captainchapster/Eigentime32/hardware/README.md

# Hardware

KiCad project goes here (`Eigentime32.kicad_pro`). Schematic order: power → RTC → MCU → LCD → lid/buttons → NFC.

Board: ~40 mm round, 0.8 mm, 2 layers. Front side bare under the LCD; all parts on the back around the CR2032 holder.
