captainchapster/Eigentime32/docs/renders/angled.png

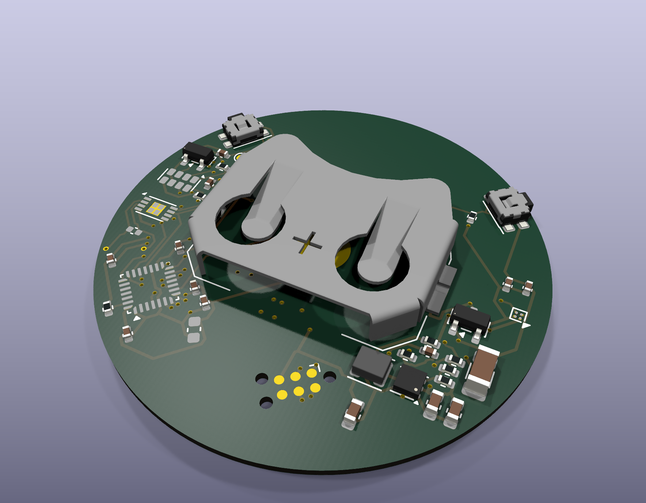
docs/renders/angled.png
