captainchapster/Eigentime32/docs/renders/bottom.png

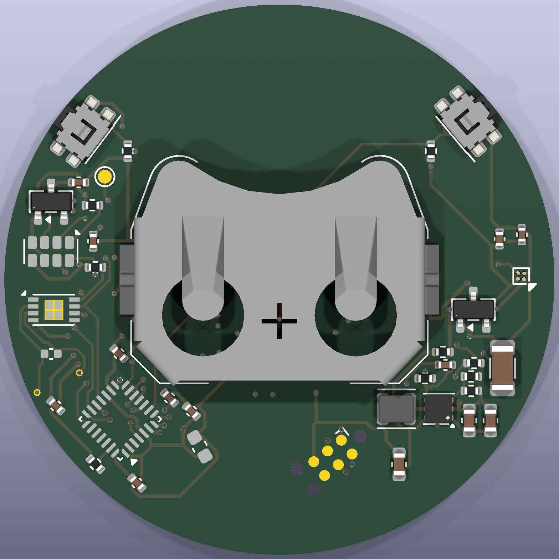
docs/renders/bottom.png
