captainchapster/Eigentime32/docs/renders/top.png

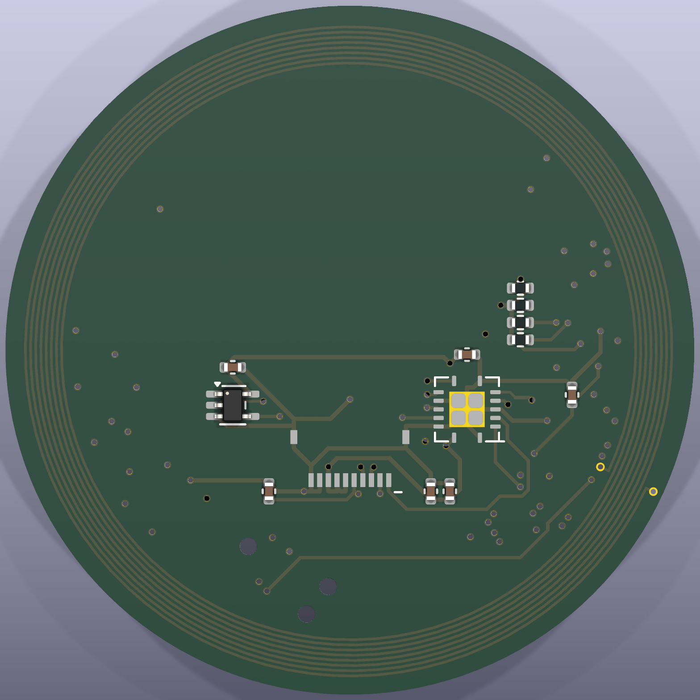
docs/renders/top.png
