captainchapster/Eigentime32/docs/renders/top_with_lcd.png

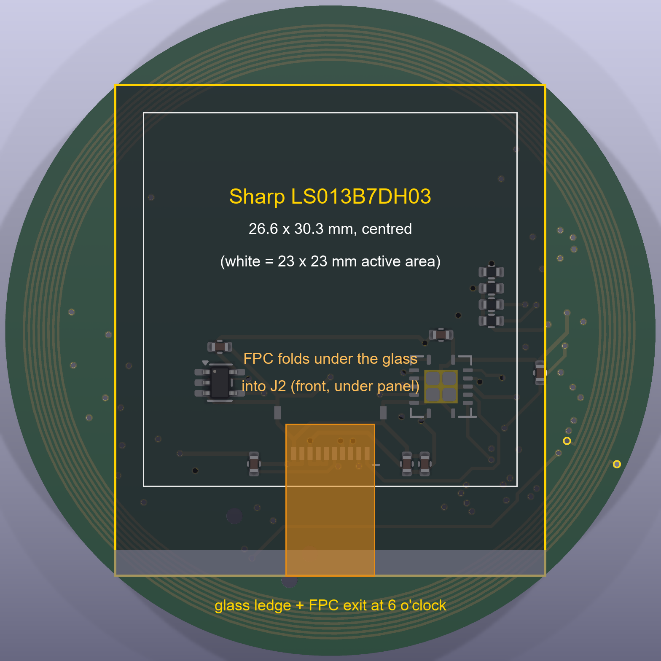
docs/renders/top_with_lcd.png
