captainchapster/Eigentime32/hardware/fab/Eigentime32_BOM_JLC.csv

Comment | Designator | Footprint | LCSC Part #
Keystone 3034 CR2032 retainer | BT1 | BatteryHolder_Keystone_3034_1x20mm_SmallNegPad | C5213768
100uF 6.3V X5R 1206 (CL31A107MQHNNNE) | C2 | C_1206_3216Metric | C15008
100nF 16V X7R 0402 (CL05B104KO5NNNC) | C3,C9,C10,C11,C12,C15,C16,C17,C20,C21 | C_0402_1005Metric | C1525
10uF 10V X5R 0603 (CL10A106KP8NNNC) | C4,C5,C6 | C_0603_1608Metric | C19702
1uF 25V X5R 0402 (CL05A105KA5NQNC) | C7,C13,C18,C19,C23 | C_0402_1005Metric | C52923
470nF 10V X5R 0402 (CL05A474KP5NNNC) | C8 | C_0402_1005Metric | C47339
1uH 2.5A WE-MAPI 2512 (Wurth 74438323010) | L1 | L_Wuerth_MAPI-2512 | C7038984
DMG2305UX-7 P-MOSFET SOT-23 | Q1 | SOT-23 | C150470
402k 1% 0402 (0402WGF4023TCE) | R1 | R_0402_1005Metric | C25785
200k 1% 0402 (0402WGF2003TCE) | R2 | R_0402_1005Metric | C25764
1M 1% 0402 (0402WGF1004TCE) | R3,R5,R12,R13,R14 | R_0402_1005Metric | C26083
470R 1% 0402 (0402WGF4700TCE) | R4 | R_0402_1005Metric | C25117
10k 1% 0402 (0402WGF1002TCE) | R6,R7,R9,R10 | R_0402_1005Metric | C25744
100k 1% 0402 (0402WGF1003TCE) | R15 | R_0402_1005Metric | C25741
Panasonic EVQ-P7A01P | SW2,SW3 | SW_SPST_EVQP7A | C79167
RV-3032-C7 32.768kHz 2.5ppm TA-QC | U1 | MicroCrystal_C7_SON-8_1.5x3.2mm_P0.9mm | C5127802
STM32L031G6U6TR | U2 | QFN-28_4x4mm_P0.5mm | C883300
TPS61099DRVR | U3 | WSON-6-1EP_2x2mm_P0.65mm_EP1x1.6mm | C2842395
TPS22916CYFPR | U5 | Texas_PicoStar_BGA-4_0.758x0.758mm_Layout2x2_P0.4mm | C2680319
ST25DV04KC-IE8C3 (UFDFPN8) | U8 | DFN-8-1EP_3x2mm_P0.5mm_EP1.36x1.46mm | C5221756
CT8132SK-IS3 | U9 | SOT-23 | C22423395
Panasonic AYF531035 FPC 10P 0.5mm | J2 | Panasonic_AYF531035_1x10-1MP_P0.5mm_Horizontal | C425133
470k 1% 0402 (0402WGF4703TCE) | R8 | R_0402_1005Metric | C25790
SN74LV4T125RGYR | U6 | Texas_RGY0014A_VQFN-14-1EP_3.5x3.5mm_P0.5mm_EP2.05x2.05mm | C411879
SN74LV1T34DCKR | U7 | SOT-353_SC-70-5 | C78541
