captainchapster/Eigentime32/case/stl/eigentime32_case.step

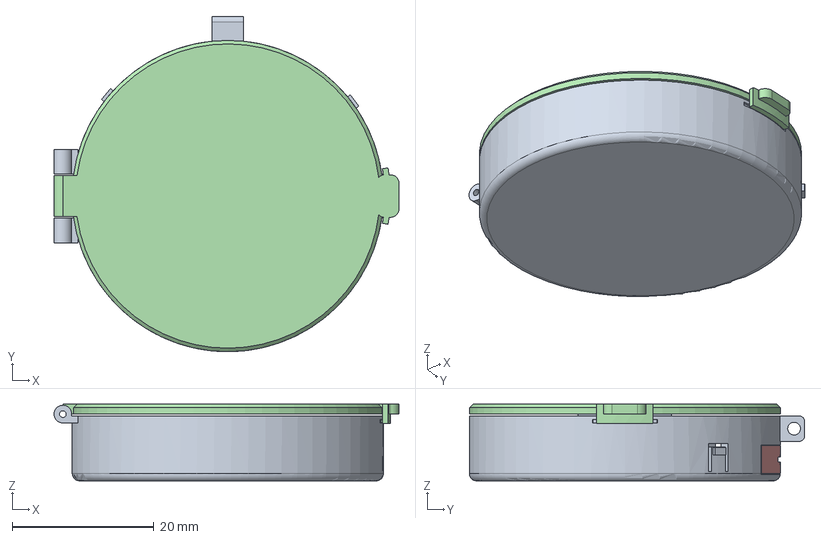
[picture p12: CAD file, 2026-10-10]
case/stl/eigentime32_case.step
48.6 x 47.3 x 10.8 mm
bezel
frame
lid
cell_door
