captainchapster/Eigentime32/case/stl/shell.step

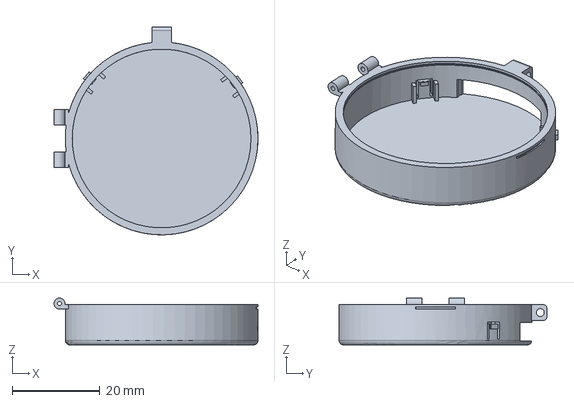
[picture p13: CAD file, 2026-10-10]
case/stl/shell.step
46.4 x 47.3 x 10.7 mm
