captainchapster/Eigentime32/case/stl/lid.step

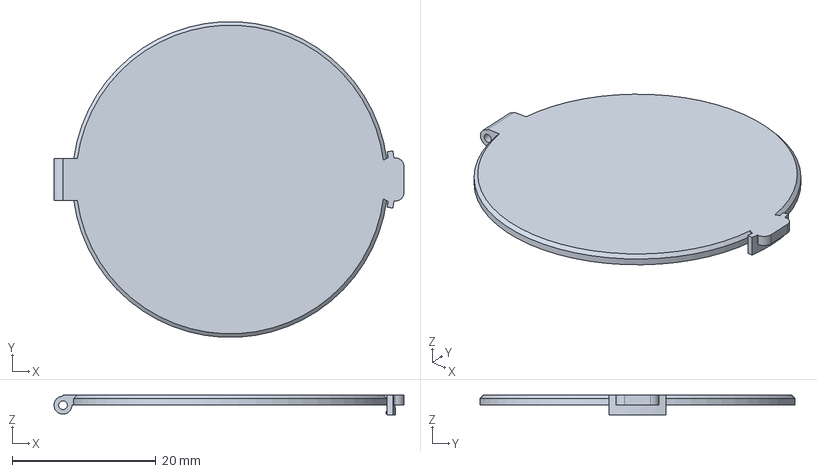
[picture p14: CAD file, 2026-10-10]
case/stl/lid.step
48.6 x 43.8 x 2.75 mm
