captainchapster/Eigentime32/case/stl/bezel.step

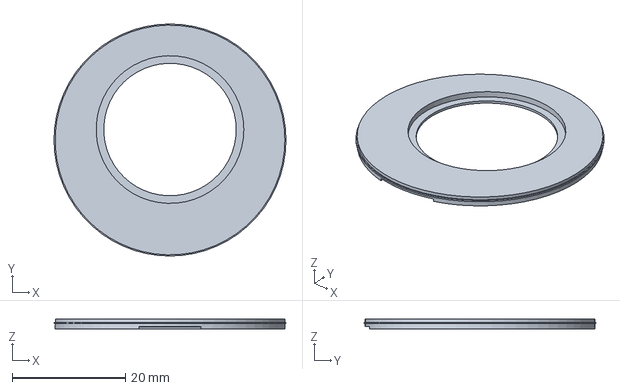
[picture p15: CAD file, 2026-10-10]
case/stl/bezel.step
41.0 x 41.0 x 1.70 mm
