captainchapster/Eigentime32/case/stl/frame.step

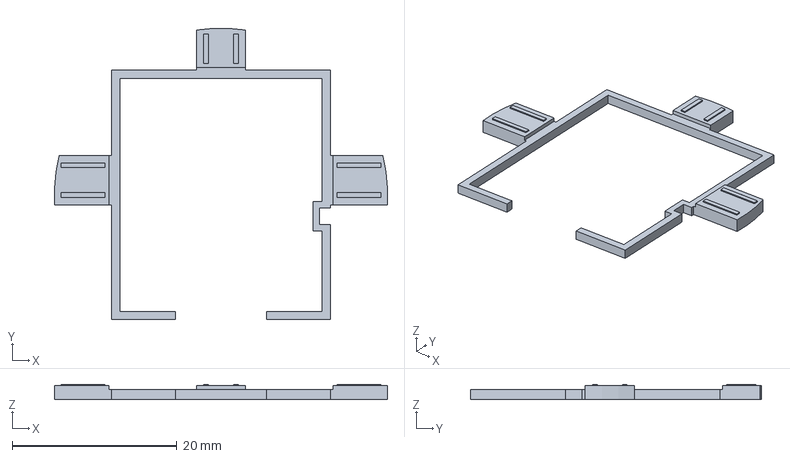
[picture p16: CAD file, 2026-10-10]
case/stl/frame.step
40.5 x 35.4 x 1.85 mm
