captainchapster/Eigentime32/case/stl/cell_door.step

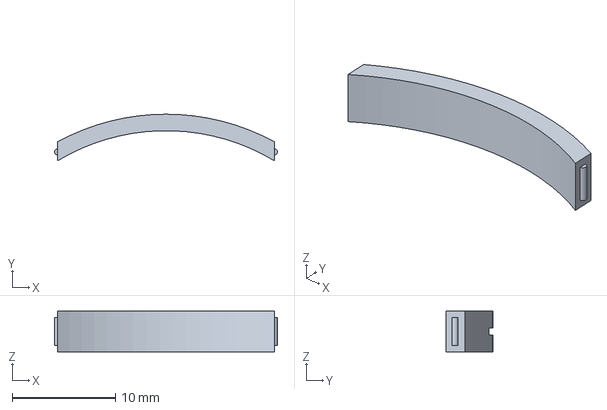
[picture p17: CAD file, 2026-10-10]
case/stl/cell_door.step
21.6 x 4.52 x 3.96 mm
