captainchapster/Eigentime32/(list of files, cad)

Other CAD files:
case/stl/bezel.stl
case/stl/cell_door.stl
case/stl/frame.stl
case/stl/lid.stl
case/stl/shell.stl
