captainchapster/Eigentime32/hardware/Eigentime32.kicad_pcb

## KiCad design hardware/Eigentime32.kicad_pcb (2026-10-10)

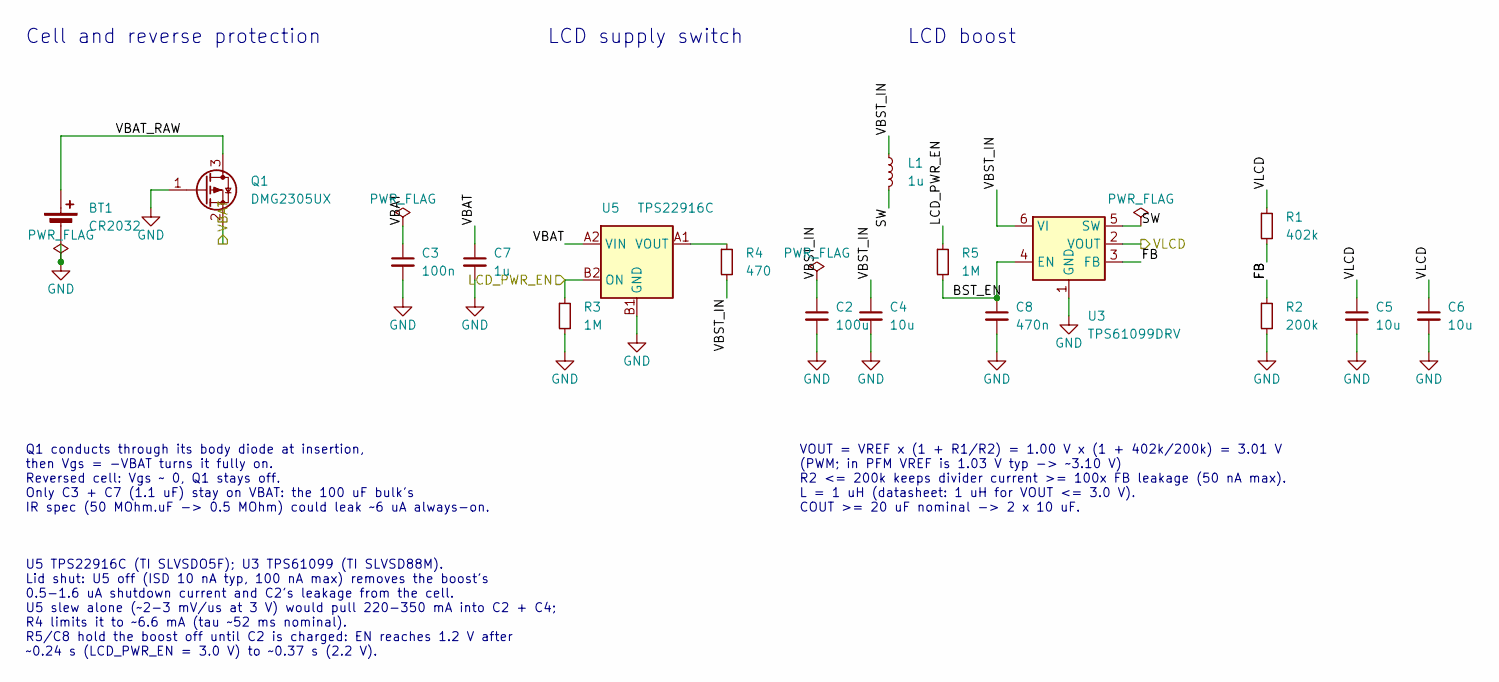
[picture p18: schematic power.kicad_sch, Eigentime32 - Power]

Parts:
BT1: CR2032; BatteryHolder_Keystone_3034_1x20mm_SmallNegPad; MPN 3034
C2: 100u; C_1206_3216Metric; MPN CL31A107MQHNNNE
C3: 100n; C_0402_1005Metric; MPN GRM155R71C104KA88D
C4, C5, C6: 10u; C_0603_1608Metric; MPN GRM188R60J106ME84D
C7: 1u; C_0402_1005Metric; MPN GRM155R61A105KE15D
C8: 470n; C_0402_1005Metric; MPN GRM155R61A474KE15D
L1: 1u; L_Wuerth_MAPI-2512; MPN 74404024010
Q1: DMG2305UX; SOT-23; MPN DMG2305UX-7
R1: 402k; R_0402_1005Metric; MPN RC0402FR-07402KL
R2: 200k; R_0402_1005Metric; MPN RC0402FR-07200KL
R3, R5: 1M; R_0402_1005Metric; MPN RC0402FR-071ML
R4: 470; R_0402_1005Metric; MPN RC0402FR-07470RL
U3: TPS61099DRV; WSON-6-1EP_2x2mm_P0.65mm_EP1x1.6mm; MPN TPS61099DRVR
U5: TPS22916C; Texas_PicoStar_BGA-4_0.758x0.758mm_Layout2x2_P0.4mm; MPN TPS22916CYFPR

Connections:
/LCD_PWR_EN: R3.1, R5.1, U5.B2 (ON); also elsewhere on the board
/Power/BST_EN: C8.1, R5.2, U3.4 (EN)
/Power/FB: R1.2, R2.1, U3.3 (FB)
/Power/SW: L1.2, U3.5 (SW)
/Power/VBAT_RAW: BT1.1 (+), Q1.3 (D)
/Power/VBST_IN: C2.1, C4.1, L1.1, R4.2, U3.6 (VI)
/VBAT: C3.1, C7.1, Q1.2 (S), U5.A2 (VIN); also elsewhere on the board
/VLCD: C5.1, C6.1, R1.1, U3.2 (VOUT); also elsewhere on the board
GND: BT1.2 (-), C2.2, C3.2, C4.2, C5.2, C6.2, C7.2, C8.2, Q1.1 (G), R2.2, R3.2, U3.1 (GND), U3.7 (GND), U5.B1 (GND); also elsewhere on the board
unnamed: R4.1, U5.A1 (VOUT)

Notes on the sheet:
Cell and reverse protection
Q1 conducts through its body diode at insertion, then Vgs = -VBAT turns it fully on. Reversed cell: Vgs ~ 0, Q1 stays off. Only C3 + C7 (1.1 uF) stay on VBAT: the 100 uF bulk's IR spec (50 MOhm.uF -> 0.5 MOhm) could leak ~6 uA always-on.
LCD supply switch
LCD boost
U5 TPS22916C (TI SLVSDO5F); U3 TPS61099 (TI SLVSD88M). Lid shut: U5 off (ISD 10 nA typ, 100 nA max) removes the boost's 0.5-1.6 uA shutdown current and C2's leakage from the cell. U5 slew alone (~2-3 mV/us at 3 V) would pull 220-350 mA into C2 + C4; R4 limits it to ~6.6 mA (tau ~52 ms nominal). R5/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
VOUT = VREF x (1 + R1/R2) = 1.00 V x (1 + 402k/200k) = 3.01 V (PWM; in PFM VREF is 1.03 V typ -> ~3.10 V) R2 <= 200k keeps divider current >= 100x FB leakage (50 nA max). L = 1 uH (datasheet: 1 uH for VOUT <= 3.0 V). COUT >= 20 uF nominal -> 2 x 10 uF.

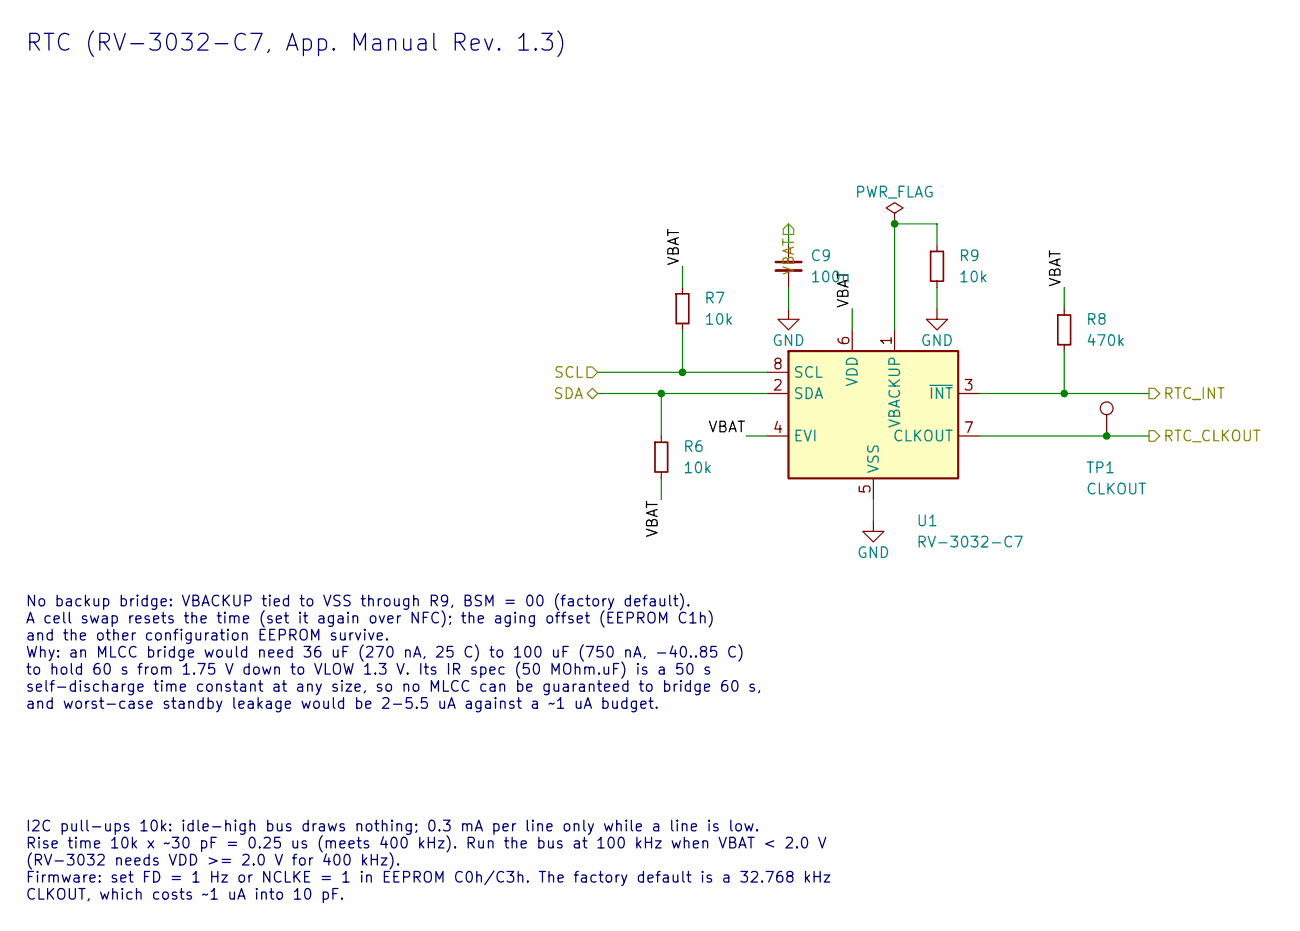
[picture p19: schematic rtc.kicad_sch, Eigentime32 - RTC]

Parts:
C9: 100n; C_0402_1005Metric; MPN GRM155R71C104KA88D
R6, R7, R9: 10k; R_0402_1005Metric; MPN RC0402FR-0710KL
R8: 470k; R_0402_1005Metric; MPN RC0402FR-07470KL
TP1: CLKOUT; TestPoint_Pad_D1.0mm
U1: RV-3032-C7; MicroCrystal_C7_SON-8_1.5x3.2mm_P0.9mm; MPN RV-3032-C7 32.768kHz 2.5ppm-TA-QC

Connections:
/RTC_CLKOUT: TP1.1, U1.7 (CLKOUT); also elsewhere on the board
/RTC_INT: R8.2, U1.3 (~INT); also elsewhere on the board
/SCL: R7.2, U1.8 (SCL); also elsewhere on the board
/SDA: R6.1, U1.2 (SDA); also elsewhere on the board
/VBAT: C9.1, R6.2, R7.1, R8.1, U1.4 (EVI), U1.6 (VDD); also elsewhere on the board
GND: C9.2, R9.2, U1.5 (VSS); also elsewhere on the board
unnamed: R9.1, U1.1 (VBACKUP)

Notes on the sheet:
RTC (RV-3032-C7, App. Manual Rev. 1.3)
No backup bridge: VBACKUP tied to VSS through R9, BSM = 00 (factory default). A cell swap resets the time (set it again over NFC); the aging offset (EEPROM C1h) and the other configuration EEPROM survive. Why: an MLCC bridge would need 36 uF (270 nA, 25 C) to 100 uF (750 nA, -40..85 C) to hold 60 s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
I2C pull-ups 10k: idle-high bus draws nothing; 0.3 mA per line only while a line is low. Rise time 10k x ~30 pF = 0.25 us (meets 400 kHz). Run the bus at 100 kHz when VBAT < 2.0 V (RV-3032 needs VDD >= 2.0 V for 400 kHz). Firmware: set FD = 1 Hz or NCLKE = 1 in EEPROM C0h/C3h. The factory default i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

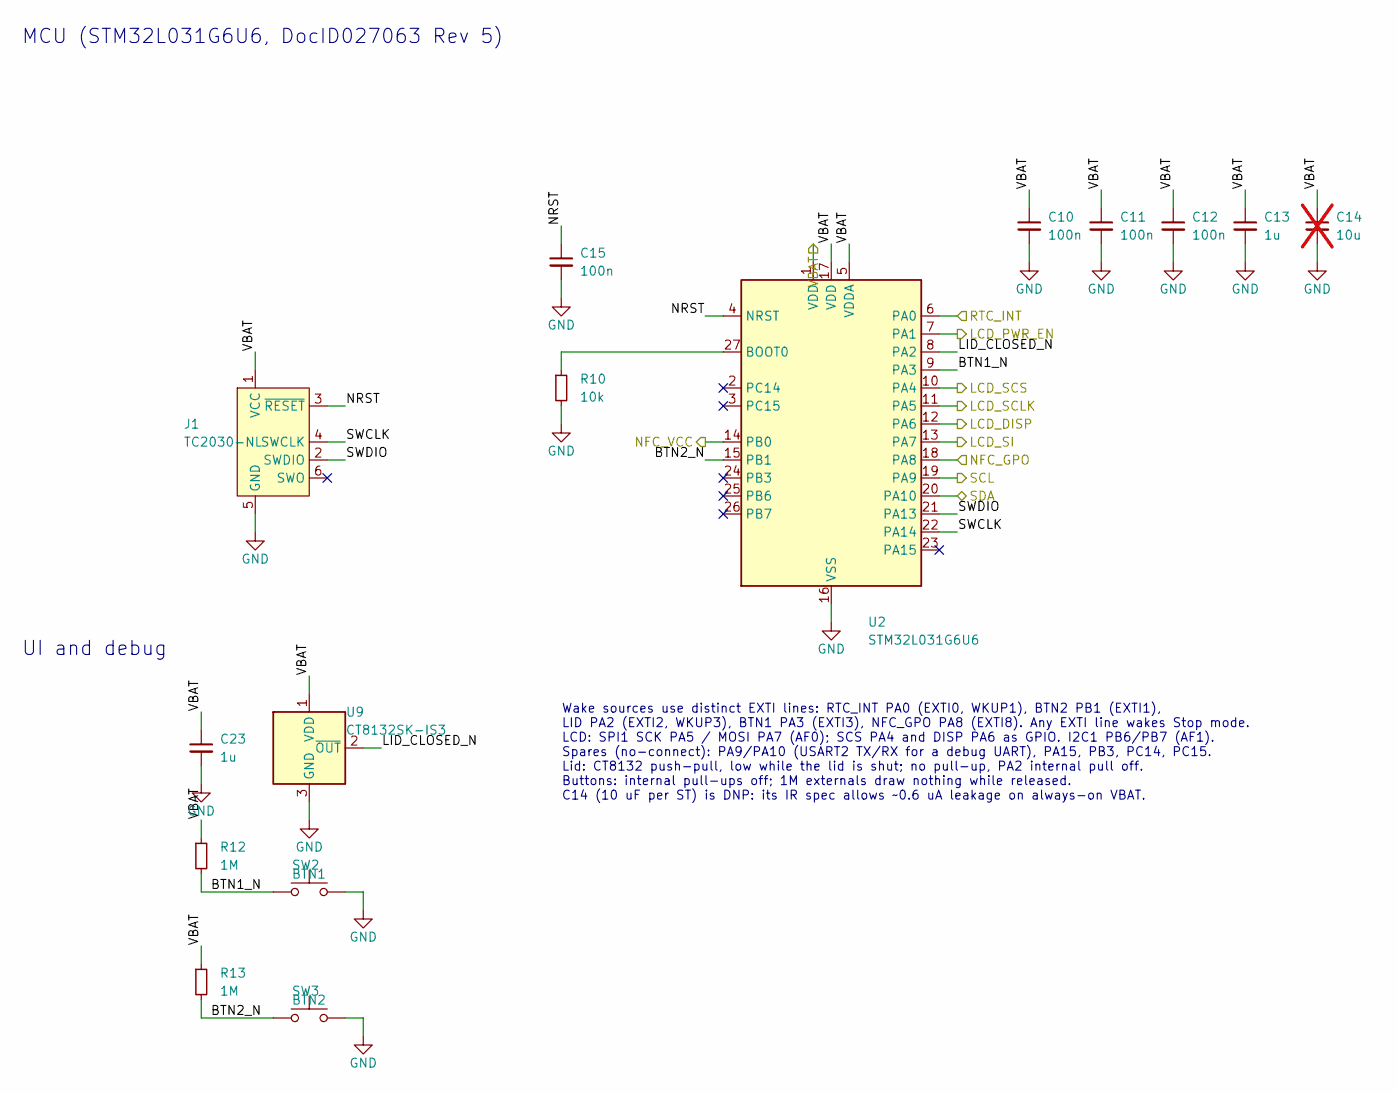
[picture p20: schematic mcu.kicad_sch, Eigentime32 - MCU]

Parts:
C10, C11, C12, C15: 100n; C_0402_1005Metric; MPN GRM155R71C104KA88D
C13, C23: 1u; C_0402_1005Metric; MPN GRM155R61A105KE15D
C14: 10u; C_0603_1608Metric; MPN GRM188R60J106ME84D; not fitted
J1: TC2030-NL; Tag-Connect_TC2030-IDC-NL_2x03_P1.27mm_Vertical_FootprintsA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; MPN TC2030-IDC-NL (cable)
R10: 10k; R_0402_1005Metric; MPN RC0402FR-0710KL
R12, R13: 1M; R_0402_1005Metric; MPN RC0402FR-071ML
SW2: BTN1; SW_SPST_EVQP7A; MPN EVQ-P7A01P
SW3: BTN2; SW_SPST_EVQP7A; MPN EVQ-P7A01P
U2: STM32L031G6U6; QFN-28_4x4mm_P0.5mm; MPN STM32L031G6U6
U9: CT8132SK-IS3; SOT-23; MPN CT8132SK-IS3

Connections:
/LCD_DISP: U2.12 (PA6); also elsewhere on the board
/LCD_PWR_EN: U2.7 (PA1); also elsewhere on the board
/LCD_SCLK: U2.11 (PA5); also elsewhere on the board
/LCD_SCS: U2.10 (PA4); also elsewhere on the board
/LCD_SI: U2.13 (PA7); also elsewhere on the board
/MCU/BTN1_N: R12.2, SW2.1, U2.9 (PA3)
/MCU/BTN2_N: R13.2, SW3.1, U2.15 (PB1)
/MCU/LID_CLOSED_N: U2.8 (PA2), U9.2 (~OUT)
/MCU/NRST: C15.1, J1.3 (~RESET), U2.4 (NRST)
/MCU/SWCLK: J1.4 (SWCLK), U2.22 (PA14)
/MCU/SWDIO: J1.2 (SWDIO), U2.21 (PA13)
/NFC_GPO: U2.18 (PA8); also elsewhere on the board
/NFC_VCC: U2.14 (PB0); also elsewhere on the board
/RTC_INT: U2.6 (PA0); also elsewhere on the board
/SCL: U2.19 (PA9); also elsewhere on the board
/SDA: U2.20 (PA10); also elsewhere on the board
/VBAT: C10.1, C11.1, C12.1, C13.1, C14.1, C23.1, J1.1 (VCC), R12.1, R13.1, U2.1 (VDD), U2.5 (VDDA), U2.17 (VDD), U9.1 (VDD); also elsewhere on the board
GND: C10.2, C11.2, C12.2, C13.2, C14.2, C15.2, C23.2, J1.5 (GND), R10.2, SW2.2, SW3.2, U2.16 (VSS), U2.28 (VSS), U9.3 (GND); also elsewhere on the board
unnamed: R10.1, U2.27 (BOOT0)

Notes on the sheet:
MCU (STM32L031G6U6, DocID027063 Rev 5)
UI and debug
Wake sources use distinct EXTI lines: RTC_INT PA0 (EXTI0, WKUP1), BTN2 PB1 (EXTI1), LID PA2 (EXTI2, WKUP3), BTN1 PA3 (EXTI3), NFC_GPO PA8 (EXTI8). Any EXTI line wakes Stop mode. LCD: SPI1 SCK PA5 / MOSI PA7 (AF0); SCS PA4 and DISP PA6 as GPIO. I2C1 PB6/PB7 (AF1). Spares (no-connect): PA9/PA10 (USAR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

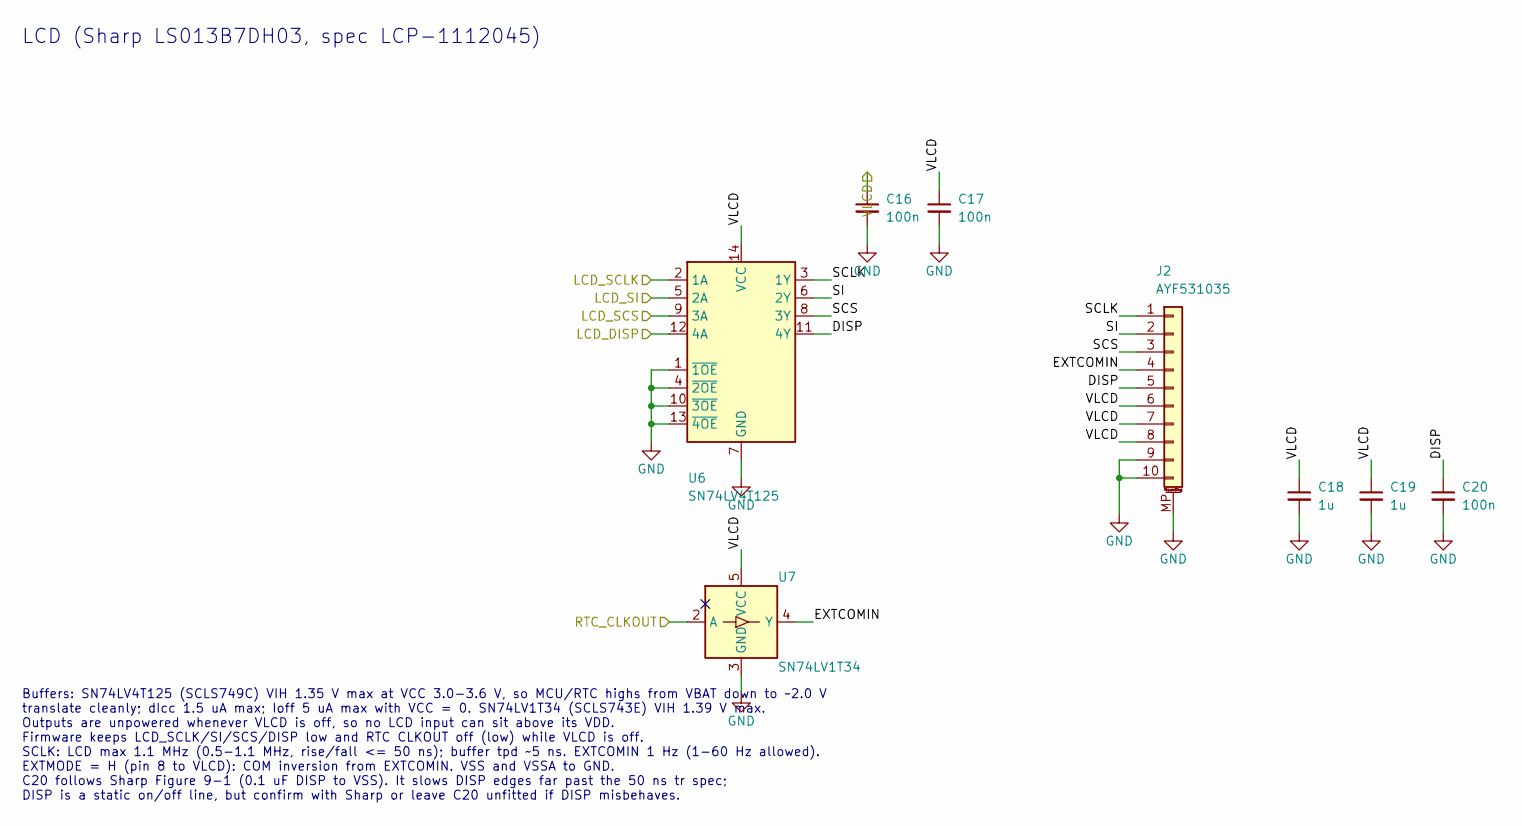
[picture p21: schematic lcd.kicad_sch, Eigentime32 - LCD]

Parts:
C16, C17, C20: 100n; C_0402_1005Metric; MPN GRM155R71C104KA88D
C18, C19: 1u; C_0402_1005Metric; MPN GRM155R61A105KE15D
J2: AYF531035; Panasonic_AYF531035_1x10-1MP_P0.5mm_Horizontal; MPN AYF531035
U6: SN74LV4T125; Texas_RGY0014A_VQFN-14-1EP_3.5x3.5mm_P0.5mm_EP2.05x2.05mm; MPN SN74LV4T125RGYR
U7: SN74LV1T34; SOT-353_SC-70-5; MPN SN74LV1T34DCKR

Connections:
/LCD/DISP: C20.1, J2.5, U6.11 (4Y)
/LCD/EXTCOMIN: J2.4, U7.4 (Y)
/LCD/SCLK: J2.1, U6.3 (1Y)
/LCD/SCS: J2.3, U6.8 (3Y)
/LCD/SI: J2.2, U6.6 (2Y)
/LCD_DISP: U6.12 (4A); also elsewhere on the board
/LCD_SCLK: U6.2 (1A); also elsewhere on the board
/LCD_SCS: U6.9 (3A); also elsewhere on the board
/LCD_SI: U6.5 (2A); also elsewhere on the board
/RTC_CLKOUT: U7.2 (A); also elsewhere on the board
/VLCD: C16.1, C17.1, C18.1, C19.1, J2.6, J2.7, J2.8, U6.14 (VCC), U7.5 (VCC); also elsewhere on the board
GND: C16.2, C17.2, C18.2, C19.2, C20.2, J2.9, J2.10, J2.MP (MountPin), U6.1 (~1OE), U6.4 (~2OE), U6.7 (GND), U6.10 (~3OE), U6.13 (~4OE), U6.15 (GND), U7.3 (GND); also elsewhere on the board

Notes on the sheet:
LCD (Sharp LS013B7DH03, spec LCP-1112045)
Buffers: SN74LV4T125 (SCLS749C) VIH 1.35 V max at VCC 3.0-3.6 V, so MCU/RTC highs from VBAT down to ~2.0 V translate cleanly; dIcc 1.5 uA max; Ioff 5 uA max with VCC = 0. SN74LV1T34 (SCLS743E) VIH 1.39 V max. Outputs are unpowered whenever VLCD is off, so no LCD input can sit above its VDD. Firmwar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

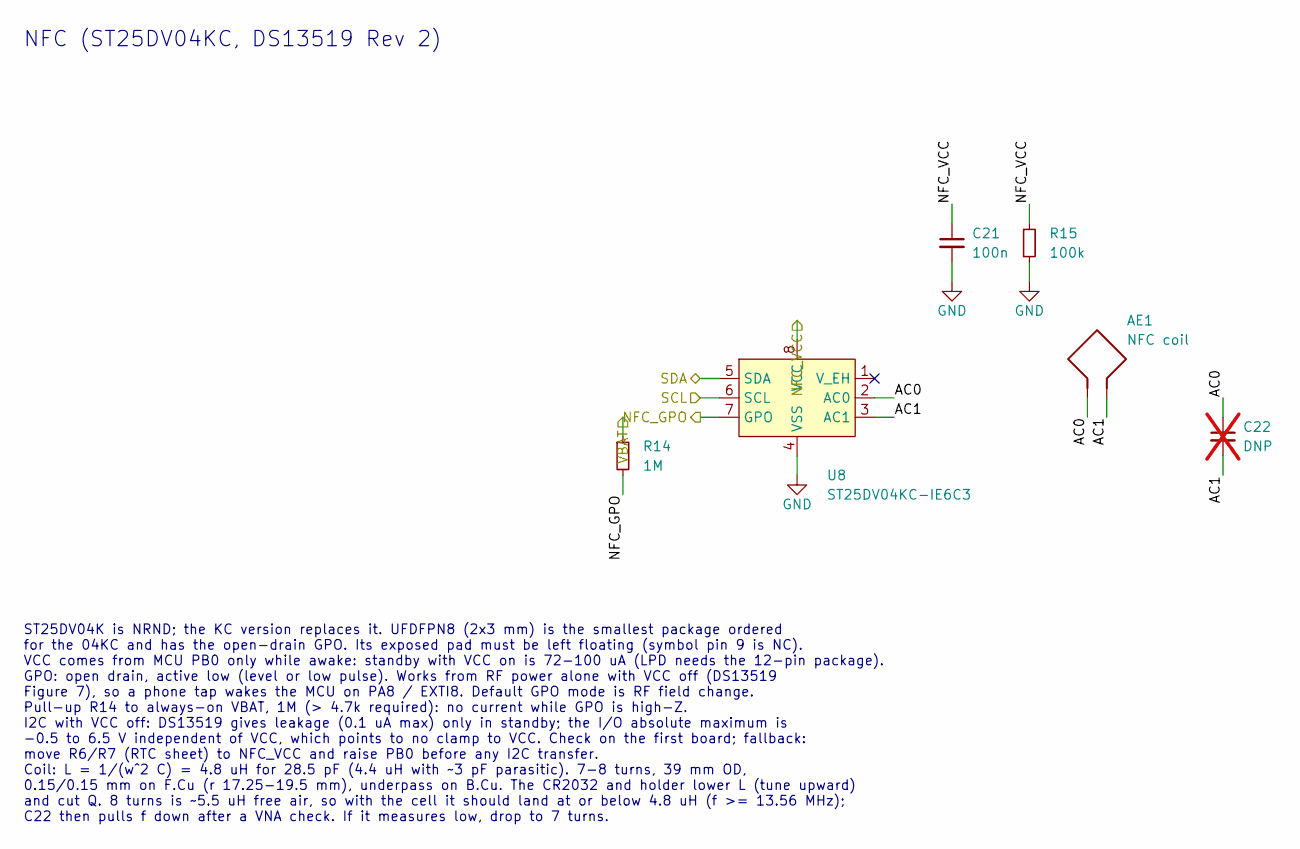
[picture p22: schematic nfc.kicad_sch, Eigentime32 - NFC]

Parts:
AE1: NFC coil; NFC_PCB_Coil_D38.1mm_8T
C21: 100n; C_0402_1005Metric; MPN GRM155R71C104KA88D
C22: DNP; C_0402_1005Metric; MPN C0G 0402, value set at tuning; not fitted
R14: 1M; R_0402_1005Metric; MPN RC0402FR-071ML
R15: 100k; R_0402_1005Metric; MPN RC0402FR-07100KL
U8: ST25DV04KC-IE6C3; DFN-8-1EP_3x2mm_P0.5mm_EP1.36x1.46mm; MPN ST25DV04KC-IE6C3

Connections:
/NFC/AC0: AE1.1, C22.1, U8.2 (AC0)
/NFC/AC1: AE1.2, C22.2, U8.3 (AC1)
/NFC_GPO: R14.2, U8.7 (GPO); also elsewhere on the board
/NFC_VCC: C21.1, R15.1, U8.8 (VCC); also elsewhere on the board
/SCL: U8.6 (SCL); also elsewhere on the board
/SDA: U8.5 (SDA); also elsewhere on the board
/VBAT: R14.1; also elsewhere on the board
GND: C21.2, R15.2, U8.4 (VSS); also elsewhere on the board

Notes on the sheet:
NFC (ST25DV04KC, DS13519 Rev 2)
ST25DV04K is NRND; the KC version replaces it. UFDFPN8 (2x3 mm) is the smallest package ordered for the 04KC and has the open-drain GPO. Its exposed pad must be left floating (symbol pin 9 is NC). VCC comes from MCU PB0 only while awake: standby with VCC on is 72-100 uA (LPD needs the 12-pin packag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

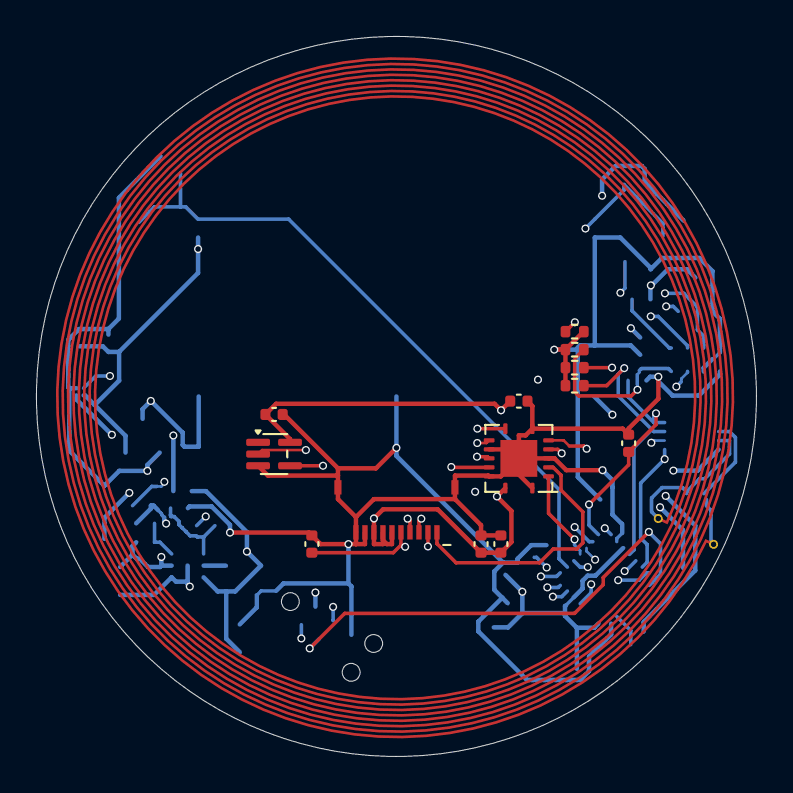
[picture p23: board Eigentime32.kicad_pcb from above]

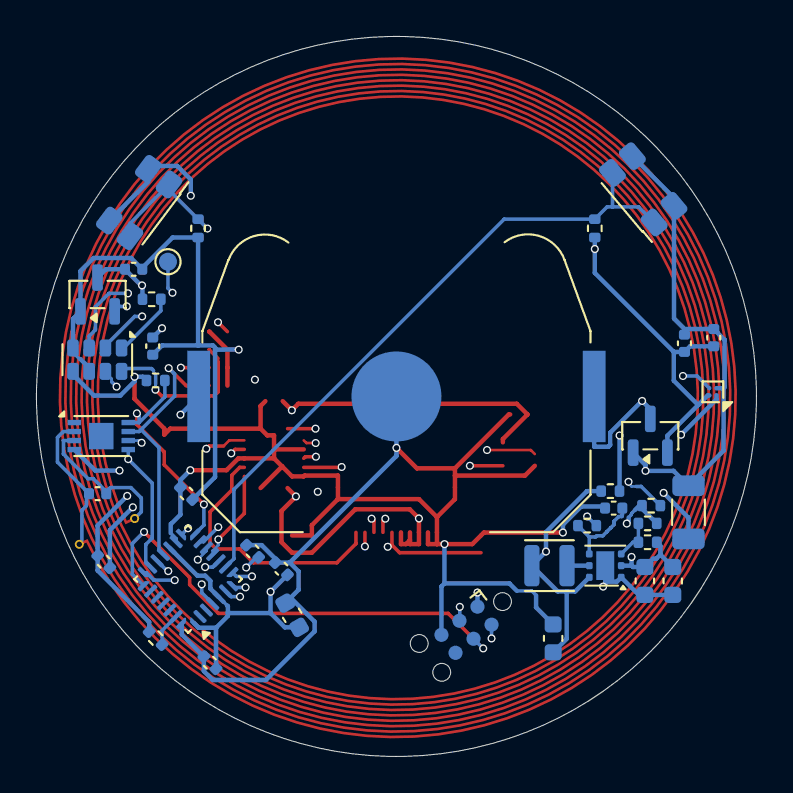
[picture p24: board Eigentime32.kicad_pcb from below]

Board: 4 copper layers, 40.0 x 40.0 mm, 53 parts (39 on the bottom side), 35 nets.
