captainchapster/Eigentime32/(commit log)

2026-10-10 Initial project structure and design docs
    Claude-Session: https://claude.ai/code/session_01FQZV81GE45WBdxJZYnuFws
    [bom.csv]
2026-10-10 Add KiCad 9 project skeleton (#1)
    * Add KiCad 9 project skeleton
    Empty schematic; PCB with 40 mm round Edge.Cuts outline centred on the
    origin, 2 copper layers, 0.8 mm board thickness. ERC and DRC clean in
    kicad-cli 9.0.7.
    * Centre board on the A4 sheet and set grid/drill origins to its centre
    ---------
    [Eigentime32.kicad_pcb, Eigentime32.kicad_sch]
2026-10-10 Full schematic: power, RTC, MCU, LCD and NFC sheets (#2)
    * Add Power schematic sheet
    CR2032 in a Keystone 3034 SMT retainer, DMG2305UX P-FET reverse
    protection (gate to GND), 100 uF + 100 nF on VBAT, and a TPS61099
    adjustable boost set to 3.0 V (R1 402k / R2 200k, 1 uH WE-LQS,
    10 uF CIN, 2 x 10 uF COUT, 1M pull-down on EN). The sheet exposes
    VBAT, VLCD and LCD_PWR_EN as hierarchical pins. ERC is clean with
    all severities enabled.
    * Power sheet: add TPS22916C switch ahead of the LCD boost
    U5 (TPS22916CYFPR) on LCD_PWR_EN cuts the TPS61099's 0.5-1.6 uA
    shutdown current and the 100 uF bulk's leakage off the cell while the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
    [Eigentime32.kicad_sch, bom.csv, lcd.kicad_sch, mcu.kicad_sch, nfc.kicad_sch, power.kicad_sch, rtc.kicad_sch]
2026-10-10 4-layer routed board with the LCD folded under the glass (#3)
    * Layout phase 1: placement, NFC coil, part picks for TBD footprints
    Board: 40 mm round, 0.8 mm, 2 layers. Front carries only the NFC coil
    (LCD keep-out rule area); every other part is on the back around the
    centred CR2032 holder (nothing taller than its 4.06 mm). Buttons at
    12 o'clock, hinge mark at 9, lid sensor at 3, LCD FPC connector at 6.
    Rules: 0.15 mm clearance, 0.2 mm tracks, 0.5/0.3 mm vias, 0.3 mm
    copper-to-edge. A rule area forbids copper pour anywhere inside the
    coil. Reference designators are on the fab layers.
    NFC coil: 8-turn Archimedean spiral on F.Cu, 38.1 mm OD, 0.15/0.15 mm,
    built as one polygon in a net-tie f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
    [Eigentime32.kicad_pcb, bom.csv, mcu.kicad_sch, nfc.kicad_sch, power.kicad_sch, rtc.kicad_sch]
2026-10-10 3D-printed pocket watch case (#4)
    Shell, snap-in bezel with round crystal window, panel frame, hinged lid
    with magnet and catch, clip-in cell door. fitcheck.py checks every part
    against the routed board, LCD, crystal and the cell insertion path.
    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
    [bezel.step, bezel.stl, cell_door.step, cell_door.stl, eigentime32_case.step, frame.step, frame.stl, lid.step]
2026-10-10 JLCPCB fabrication and assembly files (#5)
    - Gerbers + Excellon (PTH/NPTH separate) per JLC's KiCad settings,
    zipped for upload. Generated from main c302c13 after a clean DRC
    (incl. schematic parity) and ERC.
    - JLC BOM/CPL for both sides: 48 placements (13 top, 35 bottom), every
    fitted part mapped to an in-stock LCSC number; C14/C22 DNP left out.
    - README: order settings (JLC04081H-3313, ENIG recommended), live
    bare-board/stencil prices, PCBA estimate from JLC's price list,
    sourcing table, hand-solder plan, rotation checks, DFM notes.
    - bom.csv: L1 corrected to Wurth 74438323010 (WE-MAPI 2512), the part
    that matches the board footprint.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
    [Eigentime32-B_Cu.gbl, Eigentime32-B_Mask.gbs, Eigentime32-B_Paste.gbp, Eigentime32-B_Silkscreen.gbo, Eigentime32-Edge_Cuts.gm1, Eigentime32-F_Cu.gtl, Eigentime32-F_Mask.gts, Eigentime32-F_Paste.gtp]
2026-10-10 Firmware: bare-metal STM32L031 watch firmware, host tests, phone sync page
    Lid wake, Sharp LCD with changed-line updates, RV-3032 time and 1 Hz
    EXTCOMIN, button setting and :00 sync, NFC time sync from a Web NFC page
    with automatic aging-offset trimming. Builds to 17 KB; host tests cover
    calendar, NDEF and drift maths. CI builds both.
    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
    [board.c, board.h, config.h, face.c, face.h, gfx.c, gfx.h]
2026-10-10 Pre-order review notes; fix LCD fold assembly orientation in decisions
    The panel lies display side down while the FPC goes into J2, since
    folding it over flips it. After the fold the FPC contacts face up,
    which the Y5B's top and bottom contacts accept.
    Claude-Session: https://claude.ai/code/session_01Gfg3ehQi3c8MN7xXdejQnq
2026-10-10 J2: paste openings per Panasonic Y5B metal mask pattern
    Full-pad paste on the 0.5 mm pitch FPC connector risks solder wicking
    into the contacts. Panasonic's pattern uses 0.25 x 0.31 mm openings,
    0.2 mm in from the outer pad end; the mounting terminals keep 100%.
    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
    [Eigentime32.kicad_pcb]
2026-10-10 Regenerate fab Gerbers for J2 paste openings
    [Eigentime32-B_Cu.gbl, Eigentime32-B_Mask.gbs, Eigentime32-B_Paste.gbp, Eigentime32-B_Silkscreen.gbo, Eigentime32-Edge_Cuts.gm1, Eigentime32-F_Cu.gtl, Eigentime32-F_Mask.gts, Eigentime32-F_Paste.gtp]
2026-10-10 Case: hold the LCD panel with tape and a clamped frame
    Nothing fixed the panel before: it sat loose on a loose frame, held only
    by the bezel pocket and the FPC. The panel's back is now taped to the
    frame (0.05 mm transfer tape), and ears on the frame at 3, 9 and 12
    o'clock carry the bezel's clamp through crush ribs, so frame, board and
    cell holder are pressed onto the floor while the glass stays unloaded.
    Claude-Session: https://claude.ai/code/session_01Vfz9wKazh88WXFkHzFWVrz
    [bezel.step, cell_door.step, eigentime32_case.step, frame.step, frame.stl, lid.step, shell.step]
